PixelSaver/twoporthub/media/Pasted image 20260729214740.png

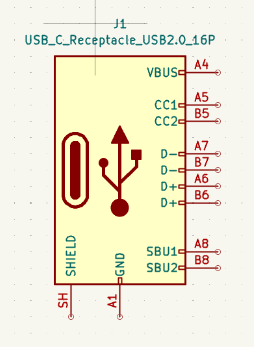
media/Pasted image 20260729214740.png
