PixelSaver/twoporthub/media/Pasted image 20260729220539.png

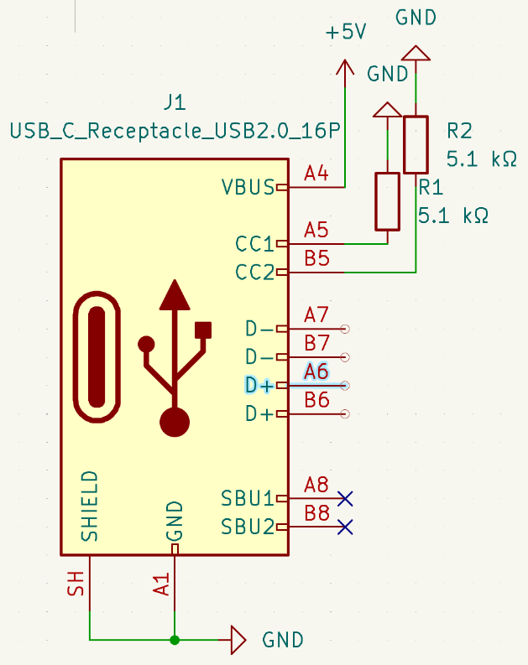
media/Pasted image 20260729220539.png
