PixelSaver/twoporthub/media/Pasted image 20260729221116.png

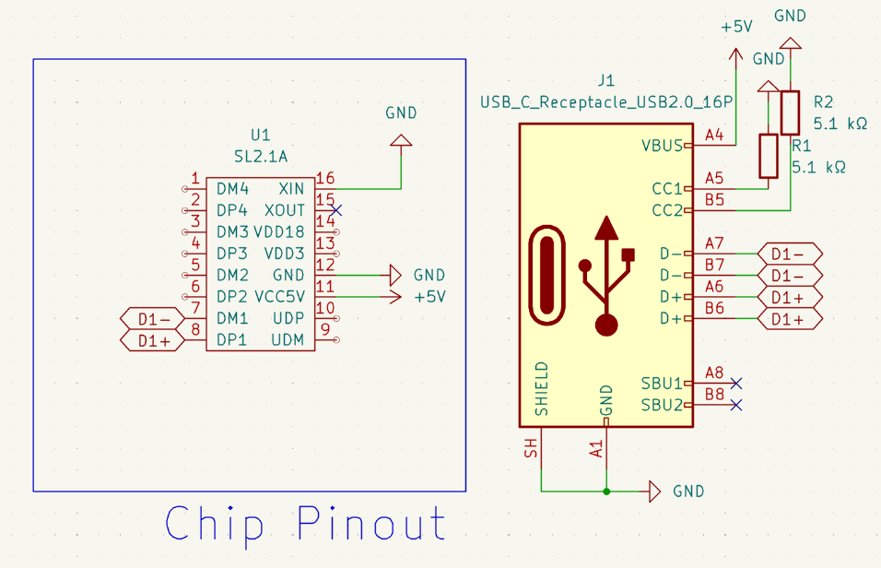
media/Pasted image 20260729221116.png
