PixelSaver/twoporthub/media/Pasted image 20260729222917.png

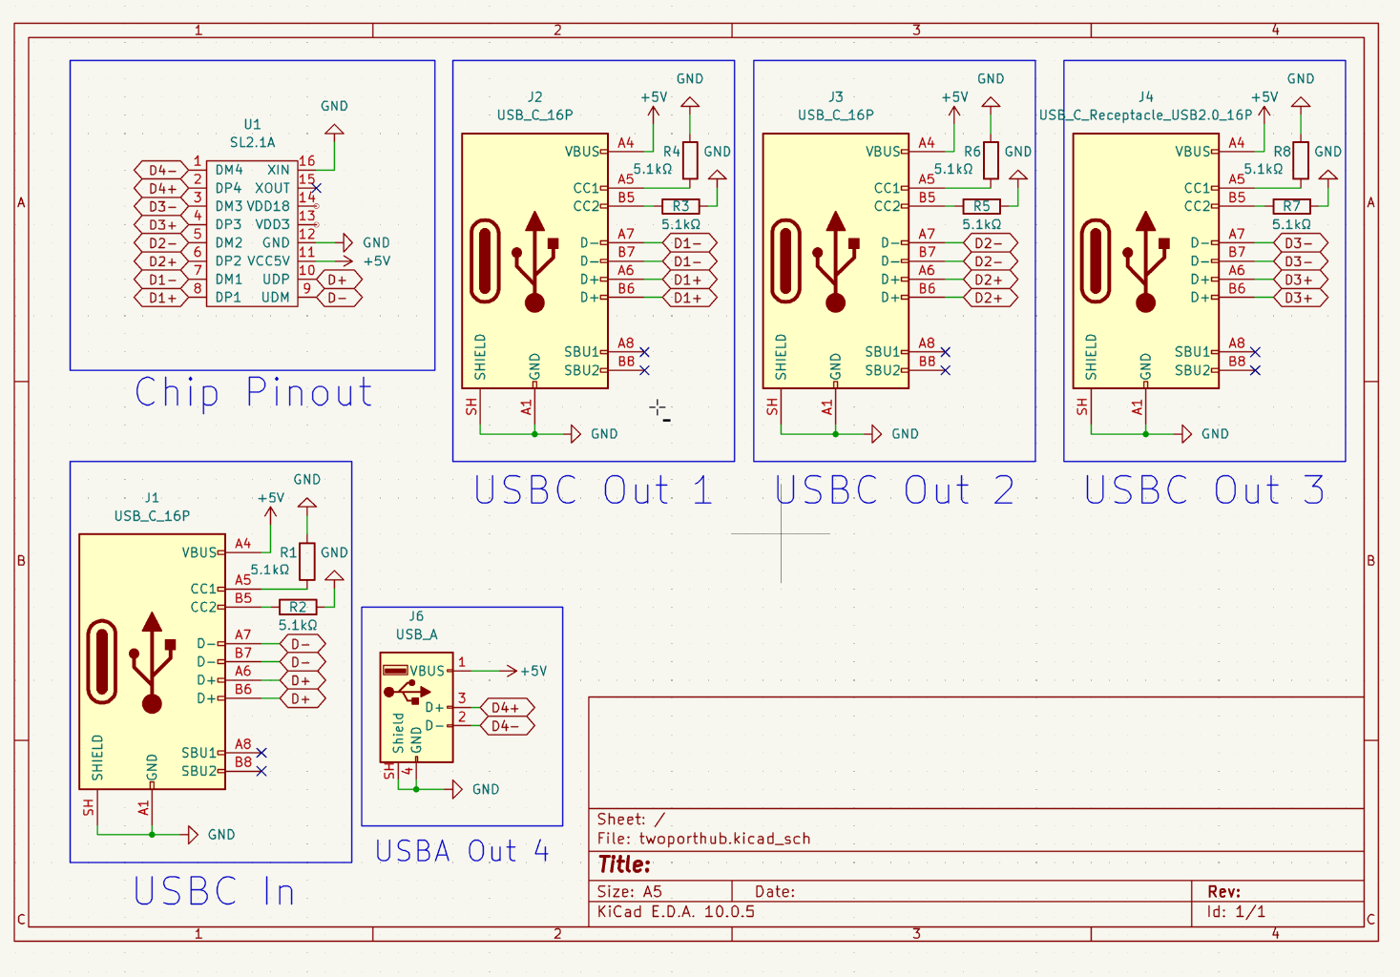
media/Pasted image 20260729222917.png
