PixelSaver/twoporthub/media/Pasted image 20260731172851.png

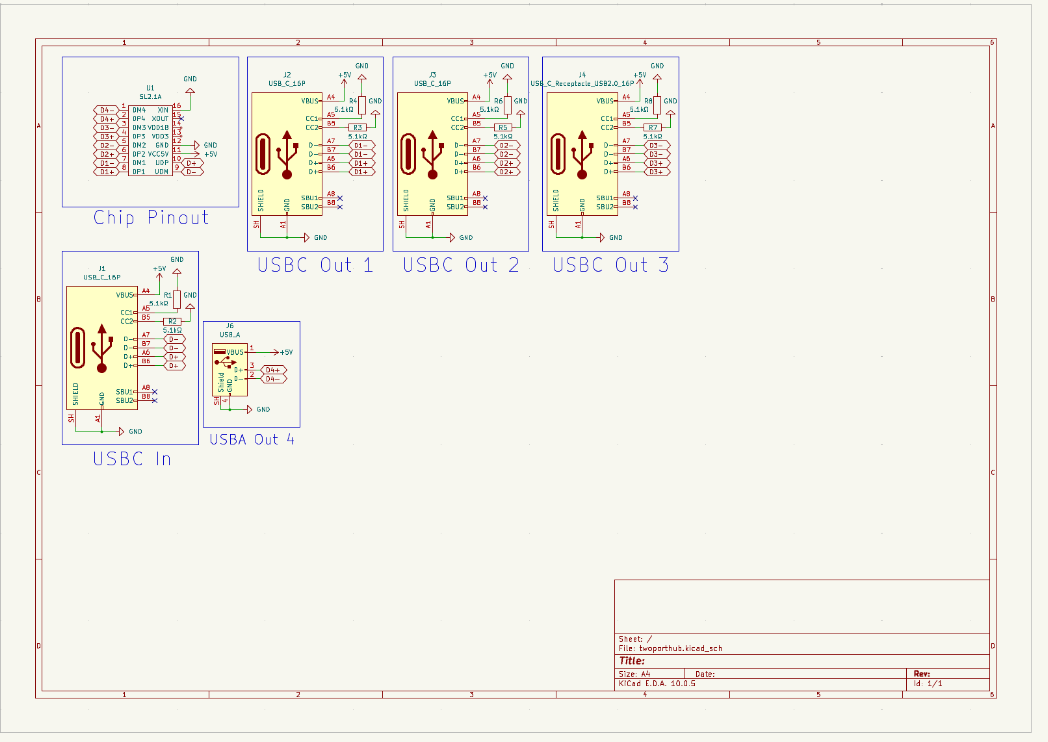
media/Pasted image 20260731172851.png
