PixelSaver/twoporthub/media/Pasted image 20260731180105.png

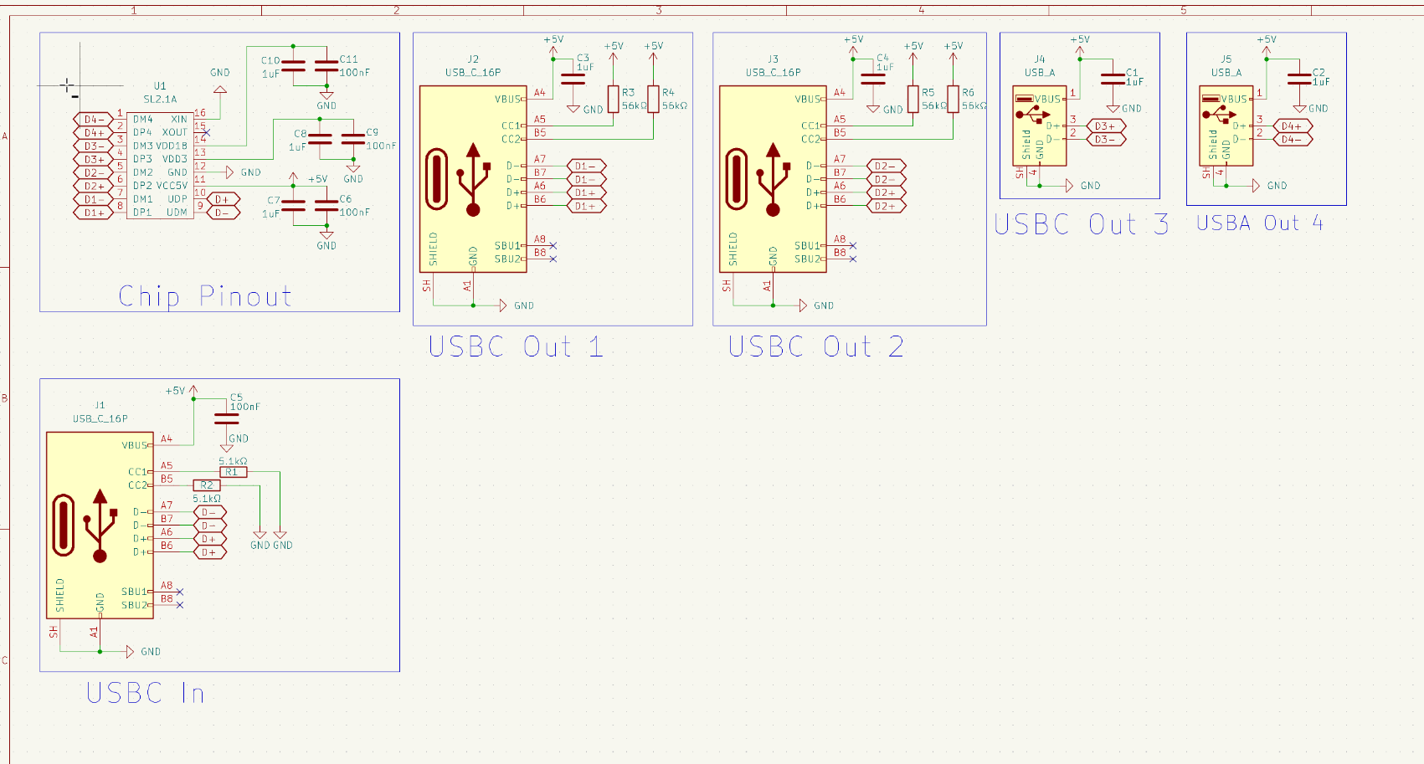
media/Pasted image 20260731180105.png
