PixelSaver/twoporthub/media/Pasted image 20260731182231.png

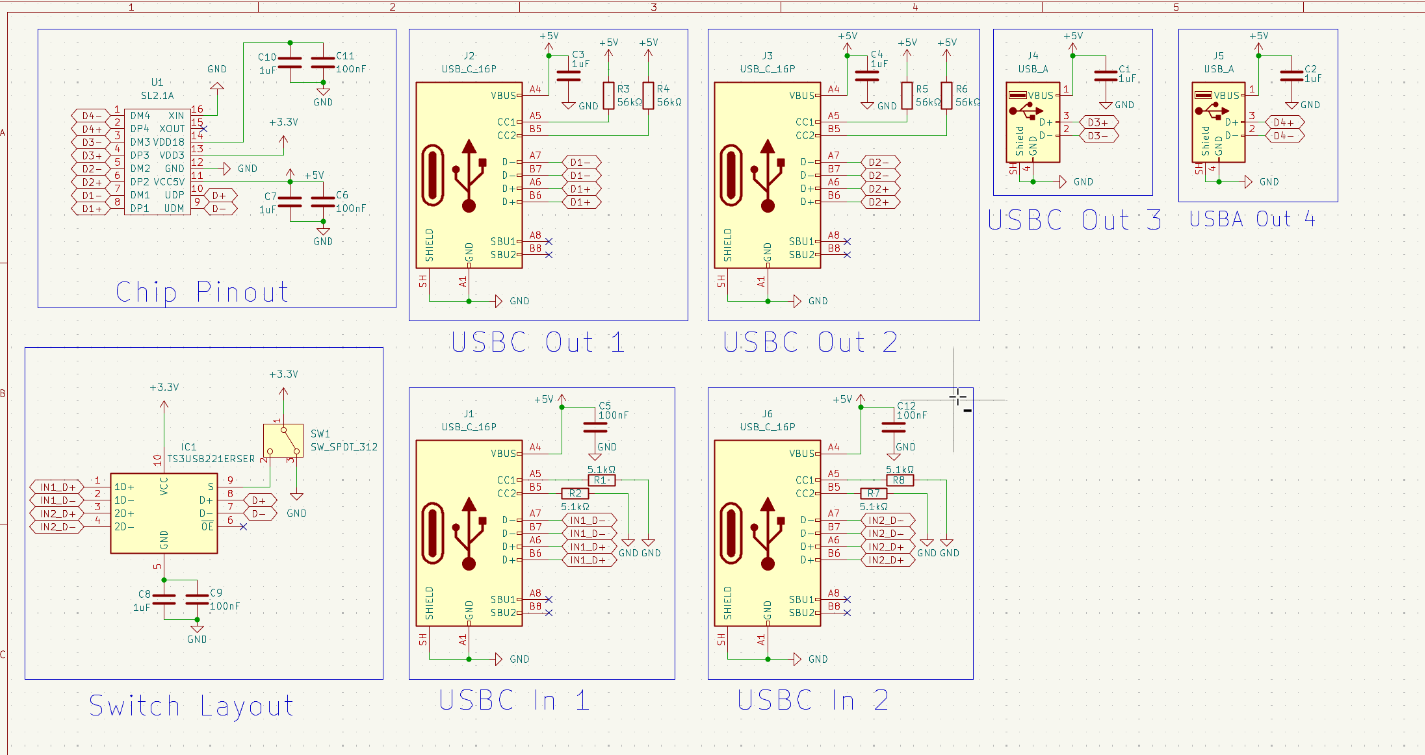
media/Pasted image 20260731182231.png
