PixelSaver/twoporthub/media/Pasted image 20260731183033.png

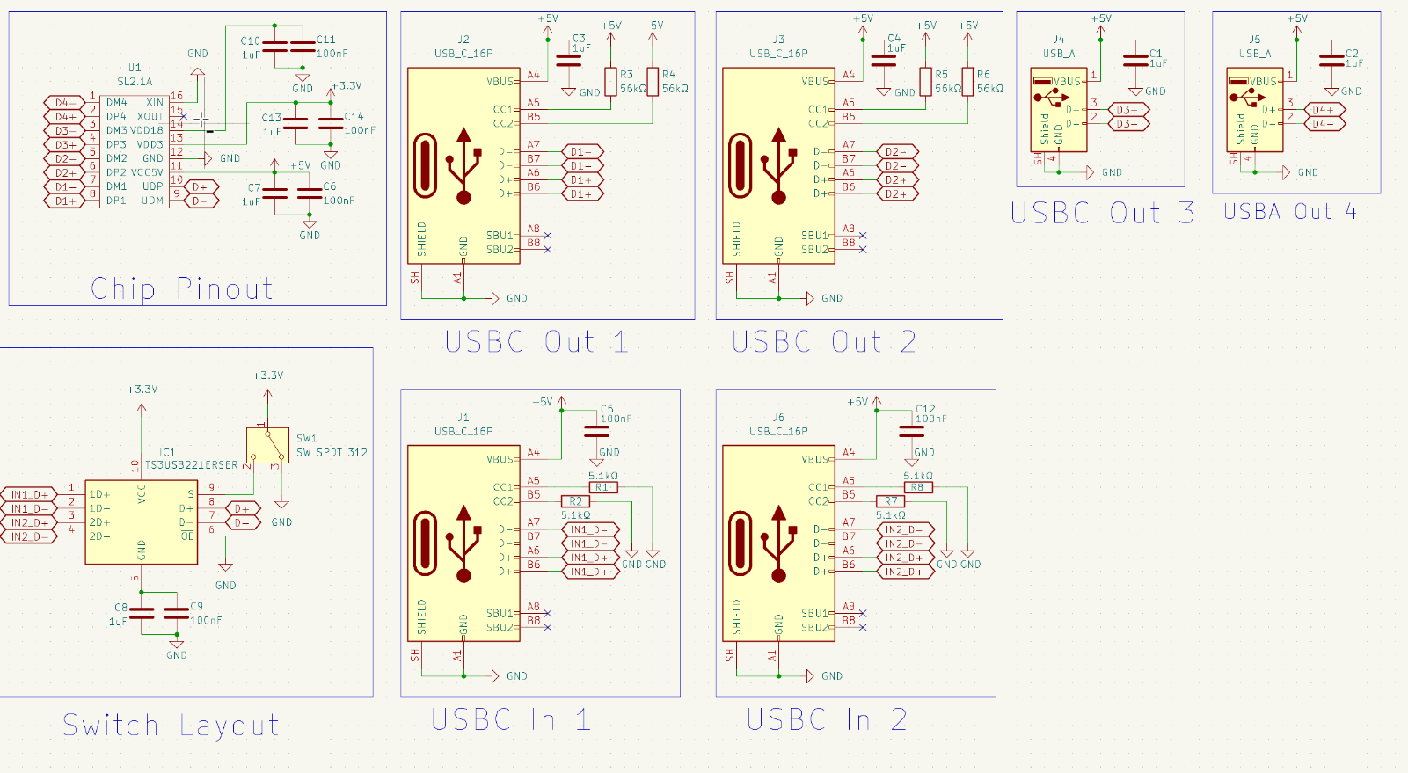
media/Pasted image 20260731183033.png
