PixelSaver/twoporthub/media/Pasted image 20260802001334.png

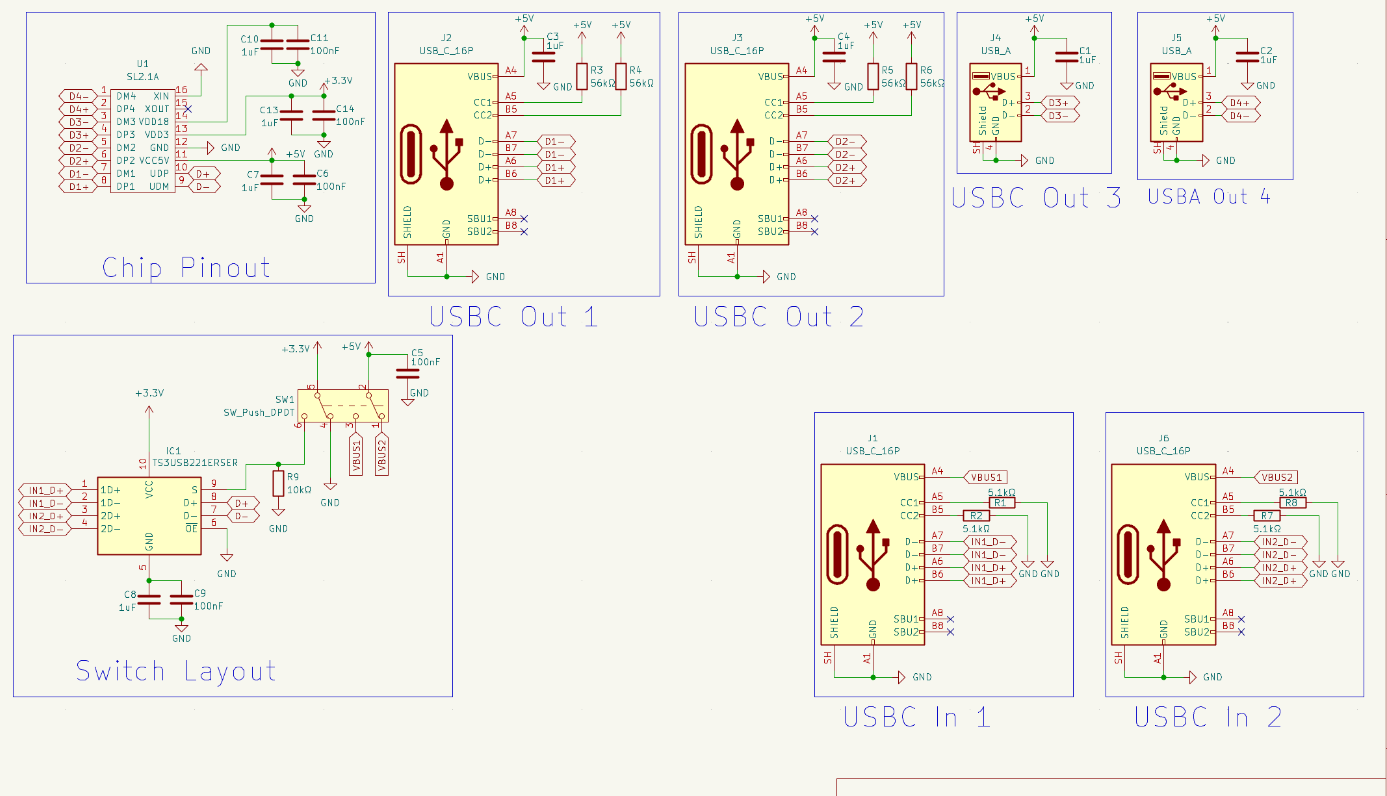
media/Pasted image 20260802001334.png
