PixelSaver/twoporthub/media/Pasted image 20260802005855.png

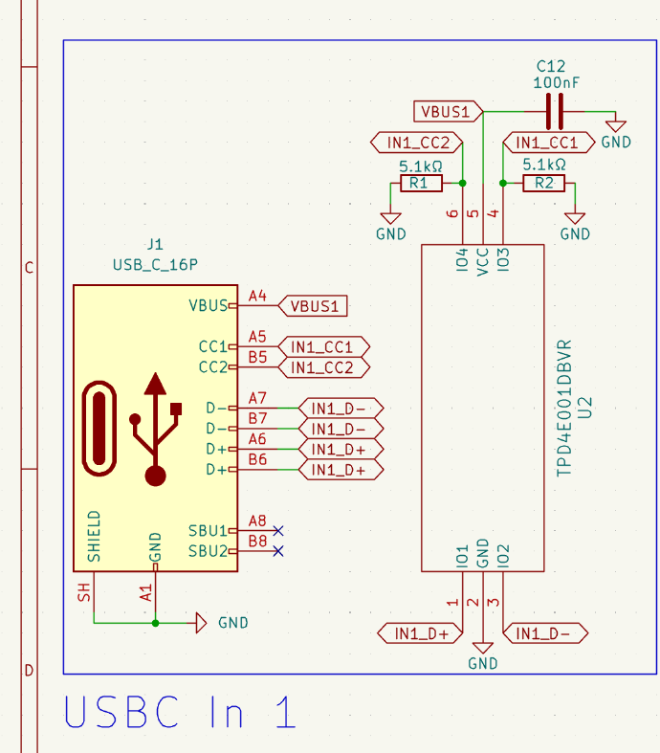
media/Pasted image 20260802005855.png
