PixelSaver/twoporthub/media/Pasted image 20260808122442.png

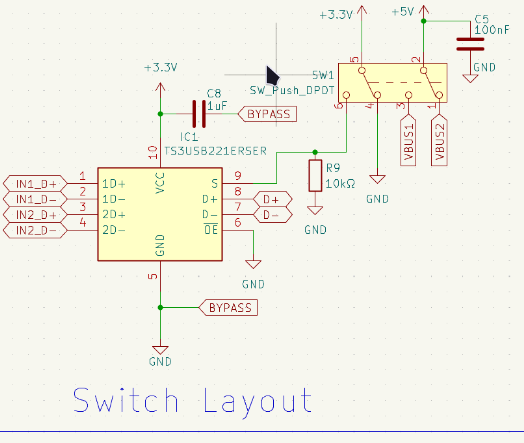
media/Pasted image 20260808122442.png
