PixelSaver/twoporthub/media/Pasted image 20260818155118.png

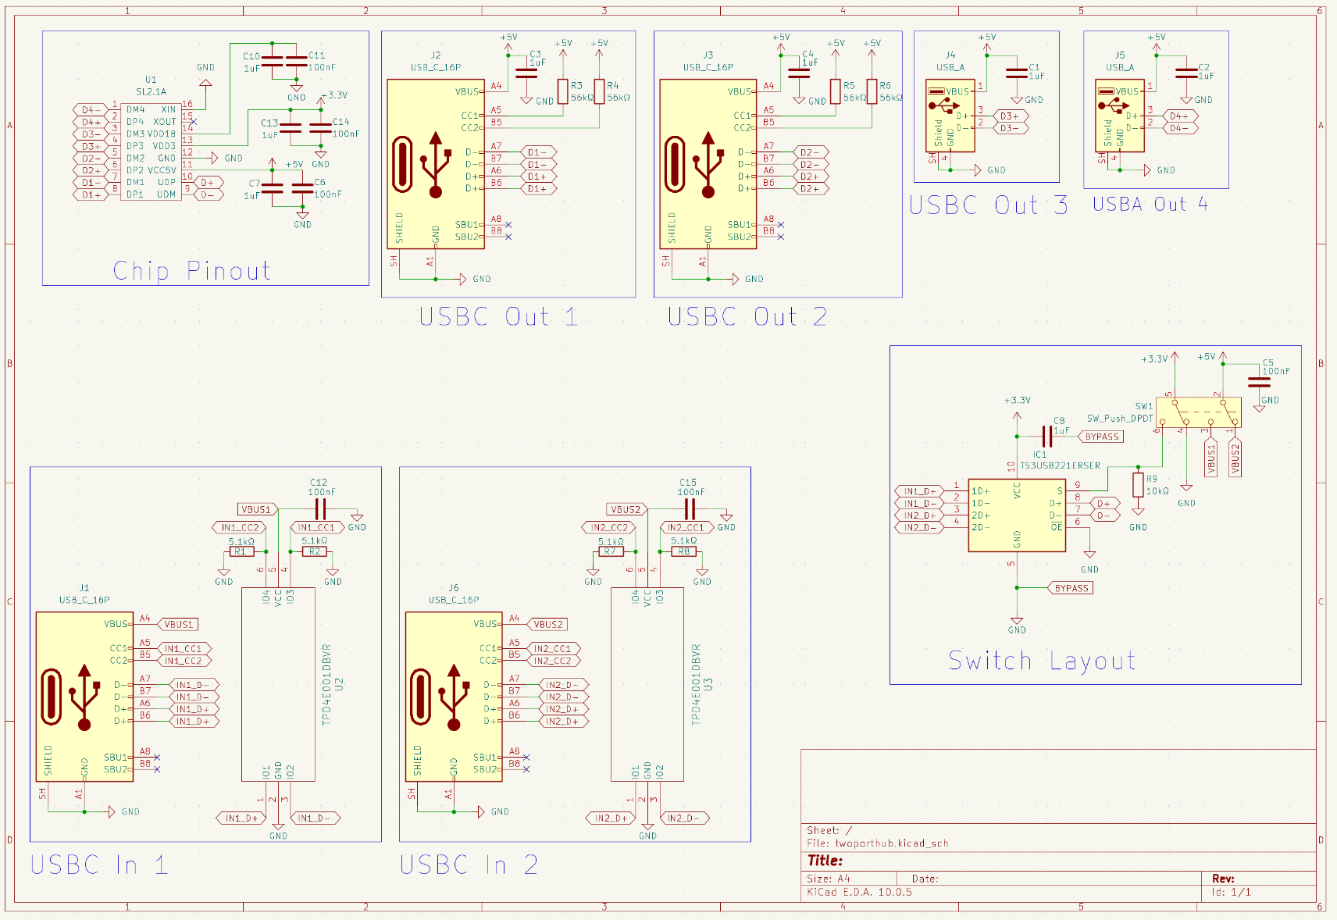
media/Pasted image 20260818155118.png
