PixelSaver/twoporthub/media/Pasted image 20260818162303.png

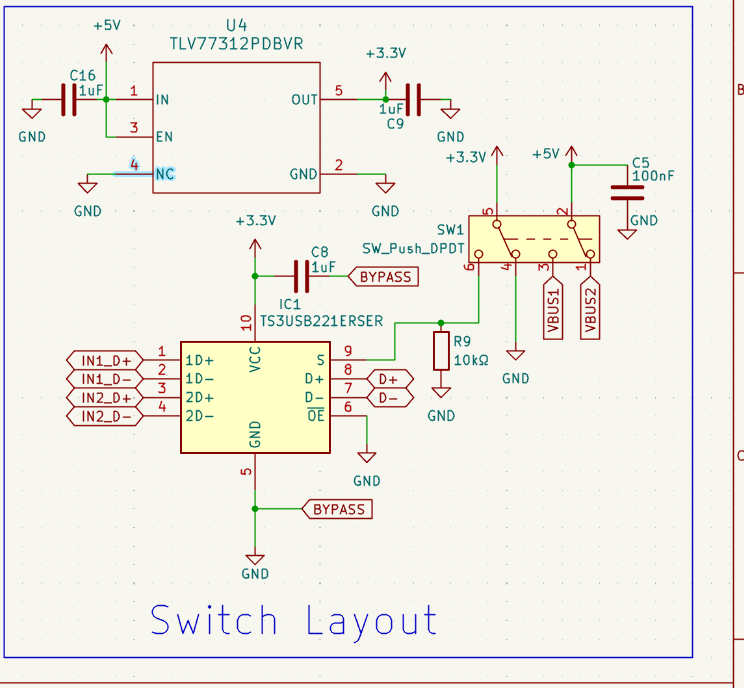
media/Pasted image 20260818162303.png
