PixelSaver/twoporthub/media/Pasted image 20260818162325.png

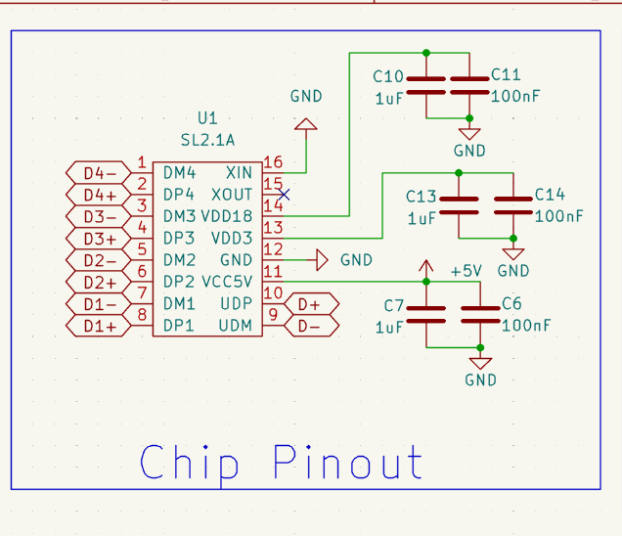
media/Pasted image 20260818162325.png
