PixelSaver/twoporthub/media/Pasted image 20260818170334.png

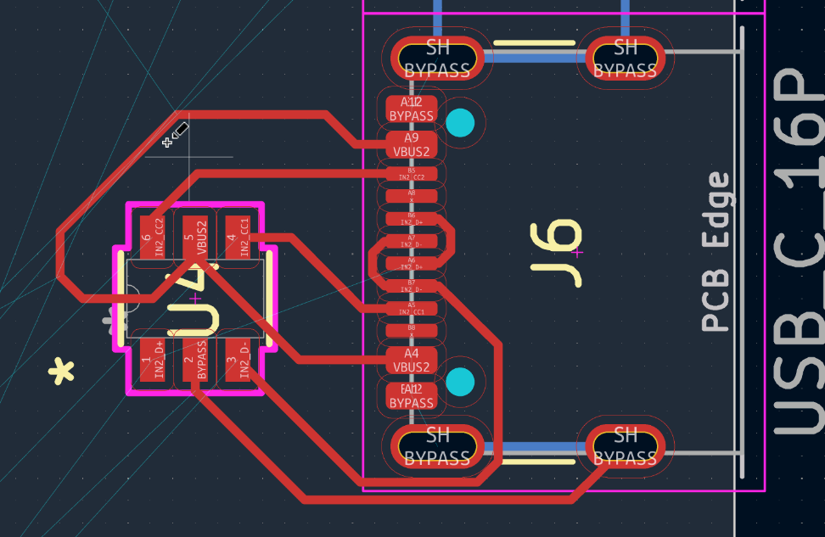
media/Pasted image 20260818170334.png
