PixelSaver/twoporthub/media/Pasted image 20260818170638.png

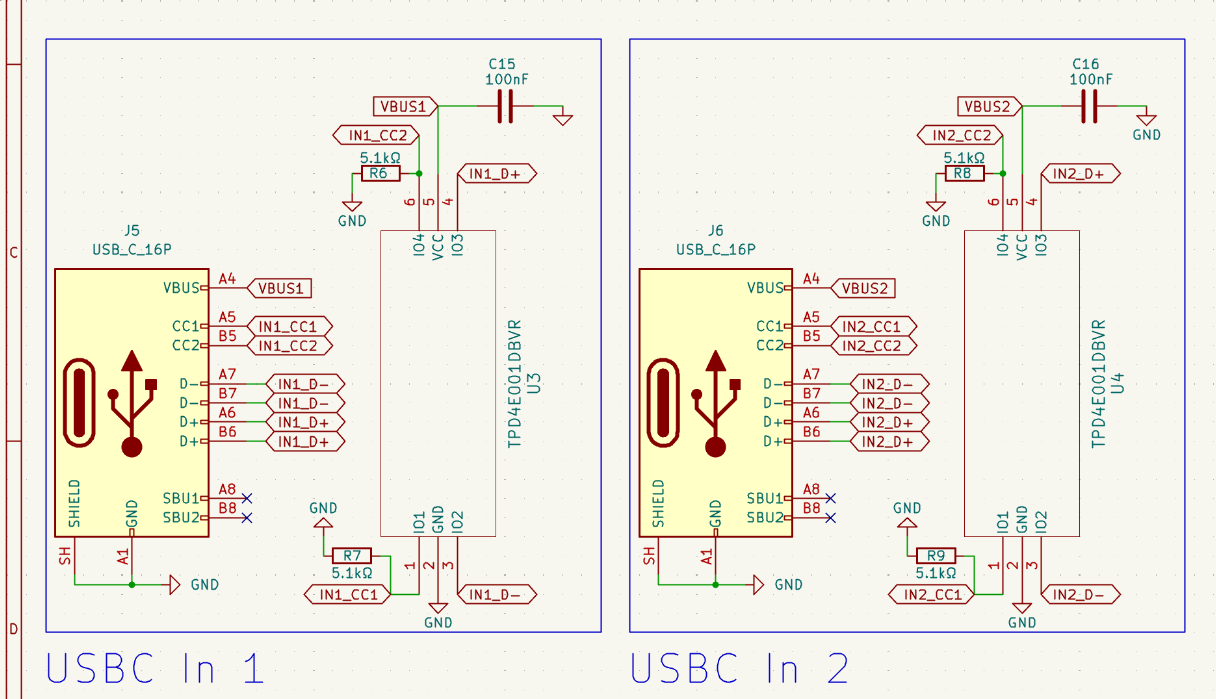
media/Pasted image 20260818170638.png
