PixelSaver/twoporthub/media/Pasted image 20260818170832.png

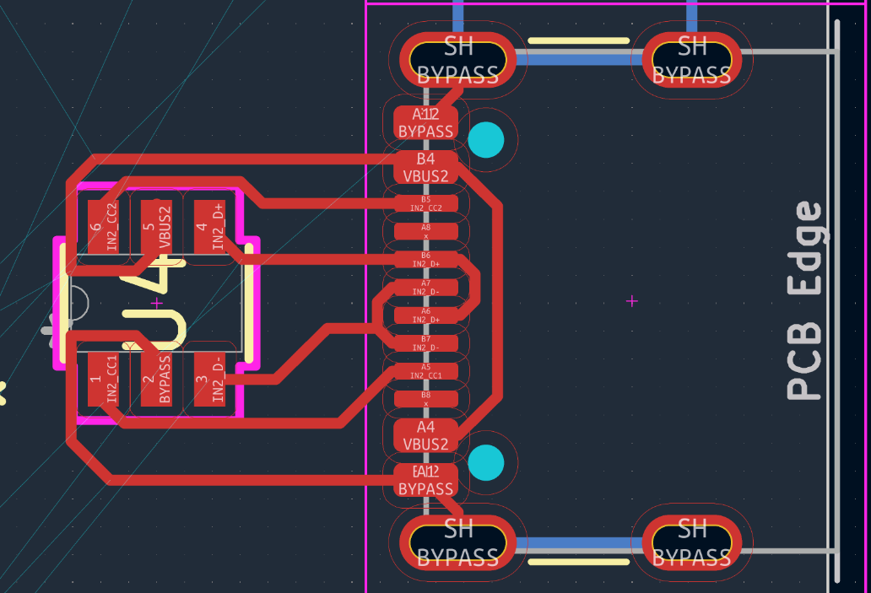
media/Pasted image 20260818170832.png
