PixelSaver/twoporthub/media/Pasted image 20260818171814.png

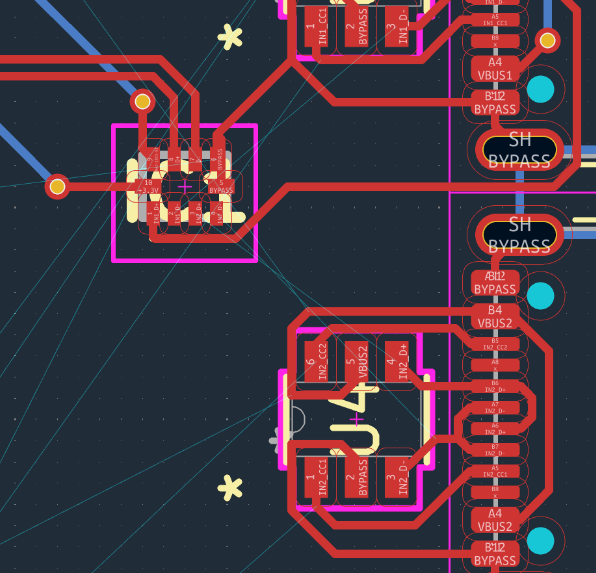
media/Pasted image 20260818171814.png
