PixelSaver/twoporthub/media/Pasted image 20260818174155.png

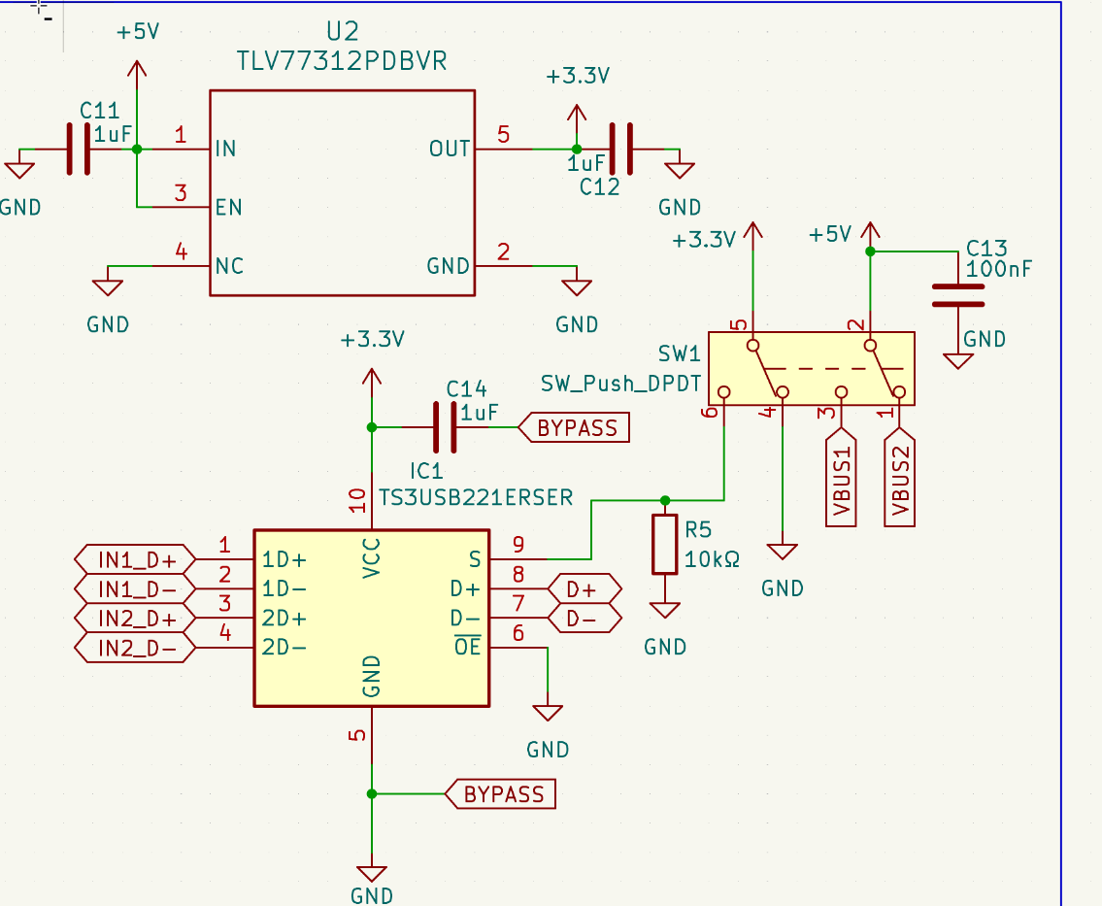
media/Pasted image 20260818174155.png
