PixelSaver/twoporthub/media/Pasted image 20260818182758.png

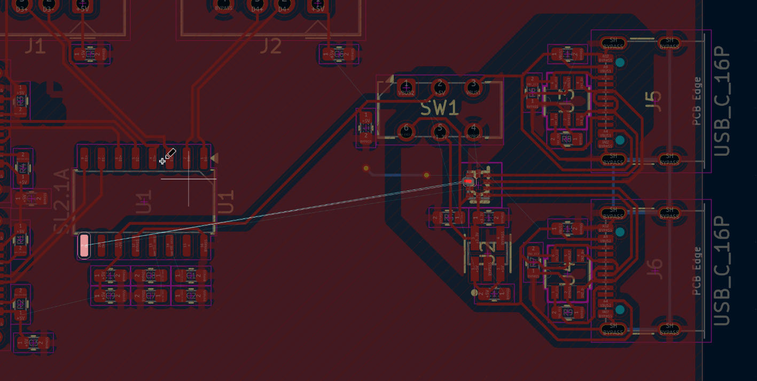
media/Pasted image 20260818182758.png
