PixelSaver/twoporthub/media/Pasted image 20260818183152.png

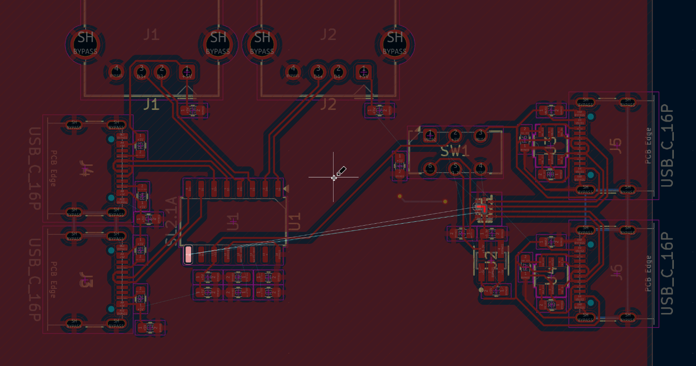
media/Pasted image 20260818183152.png
