PixelSaver/twoporthub/imports/3.3vregulator/DBV0005A.stp

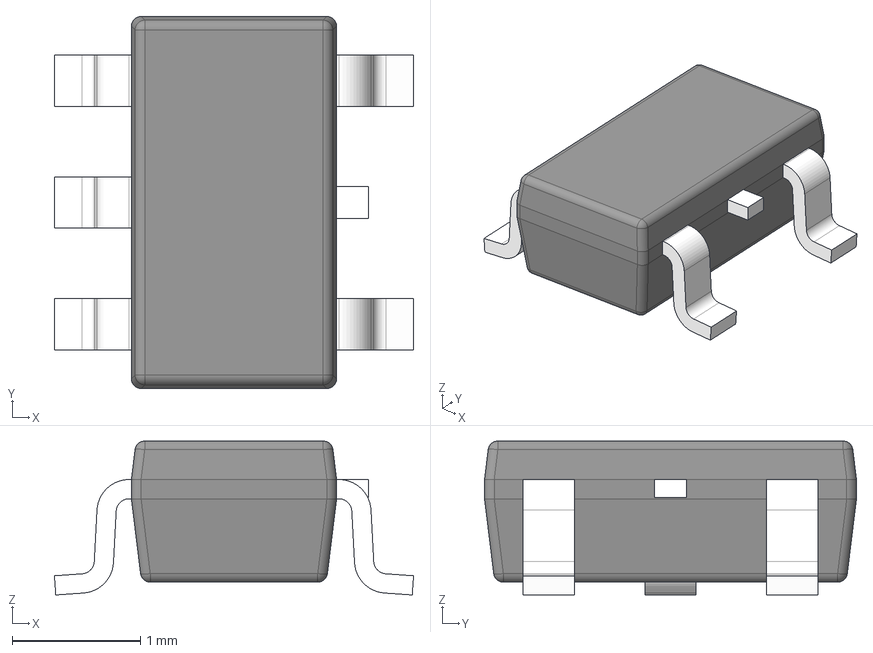
[picture p22: CAD file, 2026-08-18]
imports/3.3vregulator/DBV0005A.stp
2.80 x 2.90 x 1.20 mm
BODY-SOT
LEAD-SOT x 5
LEAD-DUMMY
