PixelSaver/twoporthub/imports/esd/DBV0006A.stp

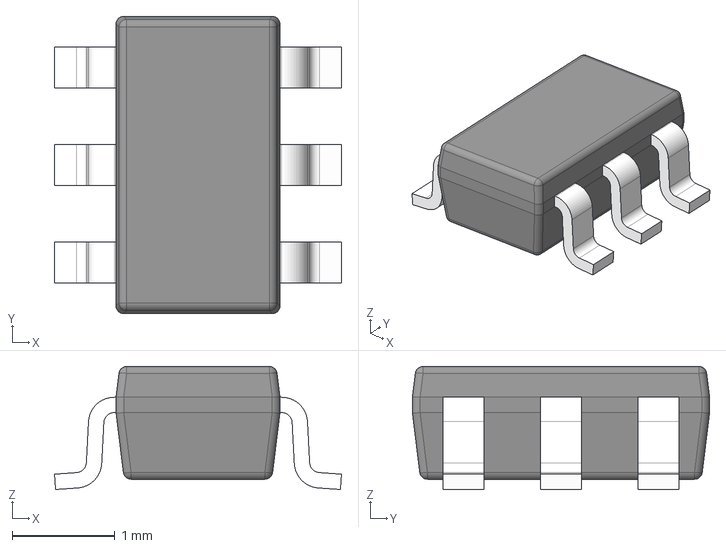
[picture p23: CAD file, 2026-08-02]
imports/esd/DBV0006A.stp
2.80 x 2.90 x 1.20 mm
BODY-SOT
LEAD-SOT x 6
