PixelSaver/twoporthub/imports/multiplexer/3D/TS3USB221ERSER.stp

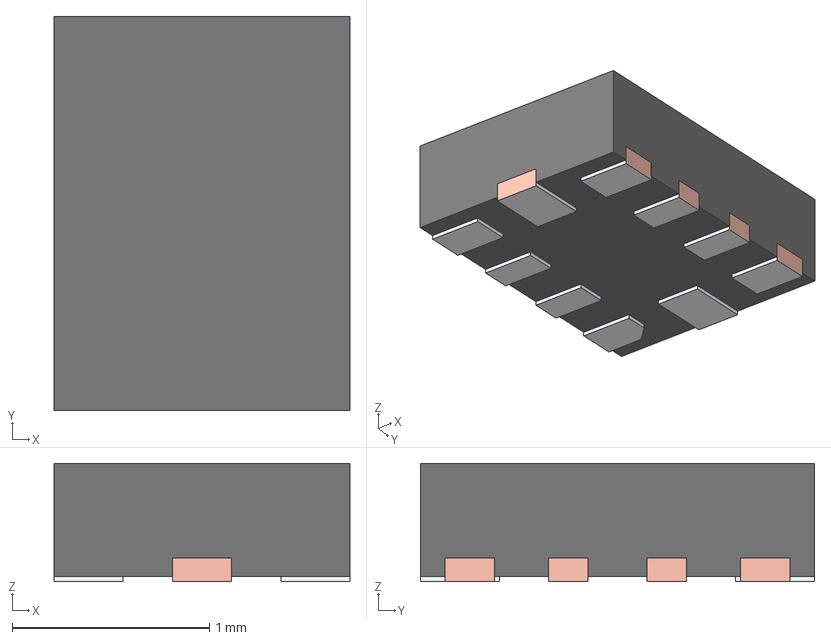
[picture p24: CAD file, 2026-08-01]
imports/multiplexer/3D/TS3USB221ERSER.stp
1.50 x 2.00 x 0.6 mm
FRAME-RSE0010A
BODY-QFN
PIN1-ID
