PixelSaver/twoporthub/imports/switch/mts102.step

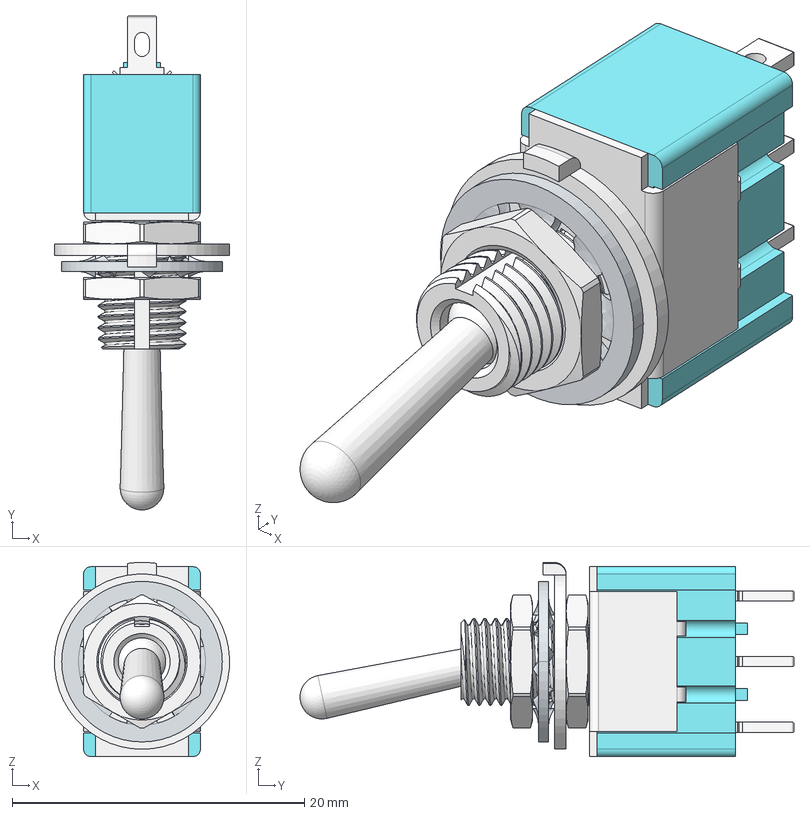
[picture p25: CAD file, 2026-08-01]
imports/switch/mts102.step
12.0 x 33.8 x 13.3 mm
Metal_part
Polyamide_body
Terminal x 3
Nut_h
Internal_Tooth_Lock_Washers
Keyed_washer
Nut_B
