PixelSaver/twoporthub/pcb/_restore_backup_2026-08-18T18-22-39-525/twoporthub.kicad_pcb

## KiCad design pcb/_restore_backup_2026-08-18T18-22-39-525/twoporthub.kicad_pcb (2026-08-19)

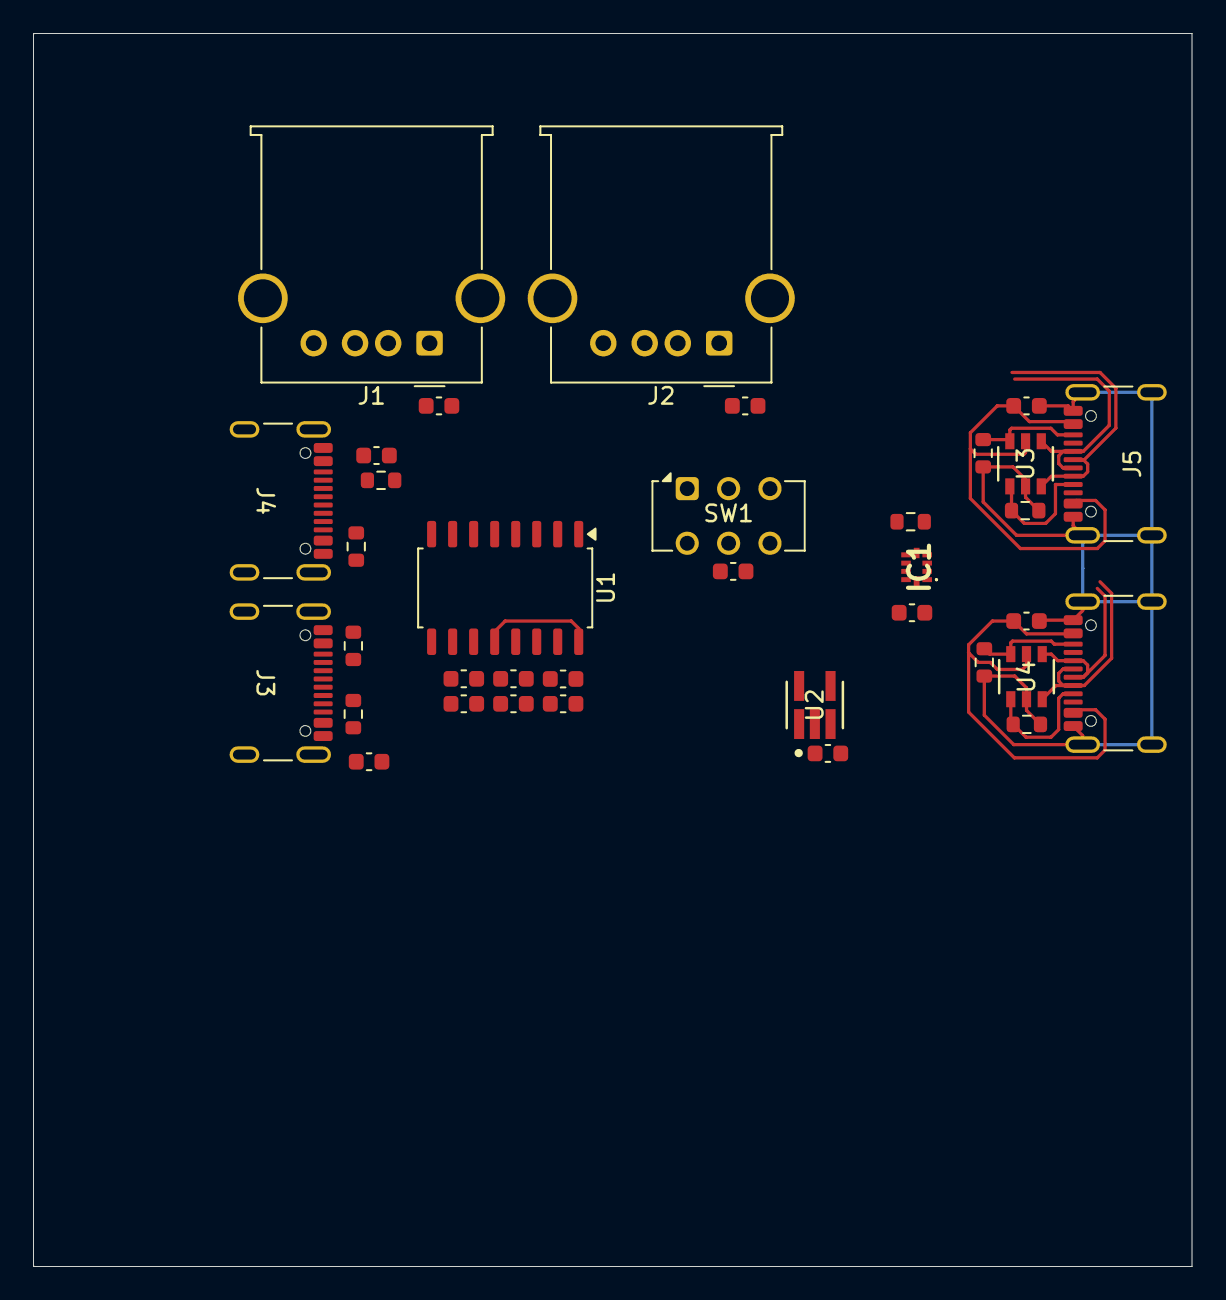
[picture p26: board twoporthub.kicad_pcb from above]

Board: 2 copper layers, 70.0 x 74.5 mm, 36 parts (0 on the bottom side), 30 nets.

Parts:
C1, C3, C4, C5, C6, C7, C9, C11, C12, C13: 1uF; C_0603_1608Metric
C2, C8, C10, C14, C15: 100nF; C_0603_1608Metric
IC1: TS3USB221ERSER
J1, J2: USB_A; USB_A_Molex_67643_Horizontal
J3, J4, J5, J6: USB_C_16P; USB_C_Receptacle_GCT_USB4105-xx-A_16P_TopMnt_Horizontal
R1, R2, R3, R4: 56kΩ; R_0603_1608Metric
R5: 10kΩ; R_0603_1608Metric
R6, R7, R8, R9: 5.1kΩ; R_0603_1608Metric
SW1: SW_Push_DPDT; SW_CK_JS202011CQN_DPDT_Straight
U1: SL2.1A; SOIC-16_4.55x10.3mm_P1.27mm
U2: TLV77312PDBVR; DBV0005A-IPC_A
U3, U4: TPD4E001DBVR; DBV6

Connections:
+3.3V: C12.2, C13.1, IC1.10 (VCC), SW1.5 (B), U2.5 (OUT)
+5V: C3.1, C4.1, C5.1, C6.1, C9.1, C10.1, C11.2, J1.1 (VBUS), J2.1 (VBUS), J3.A4 (VBUS), J3.A9 (VBUS), J3.B4 (VBUS), J3.B9 (VBUS), J4.A4 (VBUS), J4.A9 (VBUS), J4.B4 (VBUS), J4.B9 (VBUS), R1.1, R2.1, R3.1, R4.1, SW1.2 (B), U1.11 (VCC5V), U2.1 (IN), U2.3 (EN)
BYPASS: C1.2, C2.2, C3.2, C4.2, C5.2, C6.2, C7.2, C8.2, C9.2, C10.2, C11.1, C12.1, C13.2, C14.2, C15.2, IC1.5 (GND), IC1.6 (~OE), J1.4 (GND), J1.SH (Shield), J2.4 (GND), J2.SH (Shield), J3.A1 (GND), J3.A12 (GND), J3.B1 (GND), J3.B12 (GND), J3.SH (SHIELD), J4.A1 (GND), J4.A12 (GND), J4.B1 (GND), J4.B12 (GND), J4.SH (SHIELD), J5.A1 (GND), J5.A12 (GND), J5.B1 (GND), J5.B12 (GND), J5.SH (SHIELD), J6.A1 (GND), J6.A12 (GND), J6.B1 (GND), J6.B12 (GND), J6.SH (SHIELD), R5.2, R6.1, R7.1, R8.1, R9.1, SW1.4 (A), U1.12 (GND), U1.16 (XIN), U2.2 (GND), U2.4 (NC), U3.2 (GND), U4.2 (GND)
D1+: J3.A6 (D+), J3.B6 (D+), U1.8 (DP1)
D1-: J3.A7 (D-), J3.B7 (D-), U1.7 (DM1)
D2+: J4.A6 (D+), J4.B6 (D+), U1.6 (DP2)
D2-: J4.A7 (D-), J4.B7 (D-), U1.5 (DM2)
D3+: J1.3 (D+), U1.4 (DP3)
D3-: J1.2 (D-), U1.3 (DM3)
D4+: J2.3 (D+), U1.2 (DP4)
D4-: J2.2 (D-), U1.1 (DM4)
D+: IC1.8 (D+), U1.10 (UDP)
D-: IC1.7 (D-), U1.9 (UDM)
IN1_CC1: J5.A5 (CC1), R8.2, U3.1 (IO1)
IN1_CC2: J5.B5 (CC2), R6.2, U3.6 (IO4)
IN1_D+: IC1.1 (1D+), J5.A6 (D+), J5.B6 (D+), U3.4 (IO3)
IN1_D-: IC1.2 (1D-), J5.A7 (D-), J5.B7 (D-), U3.3 (IO2)
IN2_CC1: J6.A5 (CC1), R9.2, U4.1 (IO1)
IN2_CC2: J6.B5 (CC2), R7.2, U4.6 (IO4)
IN2_D+: IC1.3 (2D+), J6.A6 (D+), J6.B6 (D+), U4.4 (IO3)
IN2_D-: IC1.4 (2D-), J6.A7 (D-), J6.B7 (D-), U4.3 (IO2)
unnamed: IC1.9 (S), R5.1, SW1.6 (C)
unnamed: J3.A5 (CC1), R1.2
unnamed: J3.B5 (CC2), R2.2
unnamed: J4.A5 (CC1), R3.2
unnamed: J4.B5 (CC2), R4.2
unnamed: C7.1, C8.1, U1.13 (VDD3)
unnamed: C1.1, C2.1, U1.14 (VDD18)
VBUS1: C14.1, J5.A4 (VBUS), J5.A9 (VBUS), J5.B4 (VBUS), J5.B9 (VBUS), SW1.3 (C), U3.5 (VCC)
VBUS2: C15.1, J6.A4 (VBUS), J6.A9 (VBUS), J6.B4 (VBUS), J6.B9 (VBUS), SW1.1 (A), U4.5 (VCC)
