PixelSaver/twoporthub/simple_sl2.1a_usb_hub-main/simple_sl2.1a_usb_hub.kicad_pcb

## KiCad design simple_sl2.1a_usb_hub-main/simple_sl2.1a_usb_hub.kicad_pcb (2026-07-30)

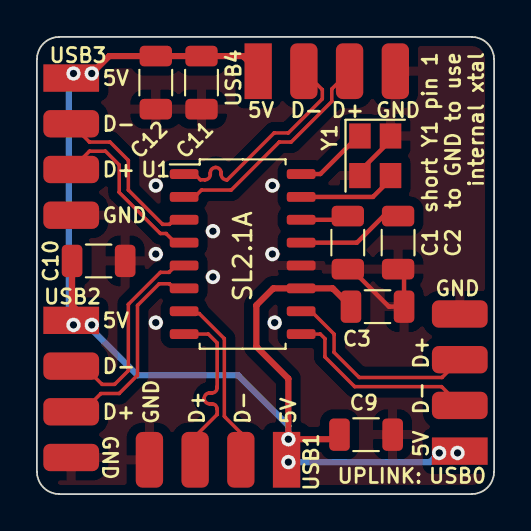
[picture p27: board simple_sl2.1a_usb_hub.kicad_pcb from above]

Board: 2 copper layers, 25.4 x 25.4 mm, 14 parts (0 on the bottom side), 16 nets.

Parts:
C1, C2, C3: 10uF; C_1206_3216Metric
C9, C10, C11, C12: 100uF/16V; C_1206_3216Metric
U1: SL2.1A; SOIC-16_4.55x10.3mm_P1.27mm
USB0, USB1, USB2, USB3, USB4: Conn_01x04_Male; 2.54mm 1x4 header edge - no silks
Y1: Crystal_GND24; Crystal_SMD_3225-4Pin_3.2x2.5mm

Connections:
D1+: U1.8 (DP1), USB1.3
D1-: U1.7 (DM1), USB1.2
D2+: U1.6 (DP2), USB2.3
D2-: U1.5 (DM2), USB2.2
D3+: U1.4 (DP3), USB3.3
D3-: U1.3 (DM3), USB3.2
D4+: U1.2 (DP4), USB4.3
D4-: U1.1 (DM4), USB4.2
DU+: U1.10 (UDP), USB0.3
DU-: U1.9 (UDM), USB0.2
Earth: C1.2, C2.2, C3.2, C9.2, C10.2, C11.2, C12.2, U1.12 (GND), USB0.4, USB1.4, USB2.4, USB3.4, USB4.4, Y1.2, Y1.4
unnamed: C1.1, U1.14 (VDD18)
unnamed: C2.1, U1.13 (VDD3)
unnamed: U1.15 (XOUT), Y1.3
unnamed: U1.16 (XIN), Y1.1
VBUS: C3.1, C9.1, C10.1, C11.1, C12.1, U1.11 (VCC5V), USB0.1, USB1.1, USB2.1, USB3.1, USB4.1
