PixelSaver/twoporthub/(commit log)

2026-07-30 Added obsidian vault, and schematiced all of it
    [simple_sl2.1a_usb_hub.kicad_pcb, simple_sl2.1a_usb_hub.kicad_sch, twoporthub.kicad_pcb, twoporthub.kicad_sch]
2026-08-01 Imported a lot of models, and wrote up schematic for two upstream nodes and a switch
    [TS3USB221ERSER.stp, mts102.step, twoporthub.kicad_pcb, twoporthub.kicad_sch]
2026-08-02 Added esd protection to one poirt so far
    [DBV0006A.stp, twoporthub.kicad_sch]
2026-08-18 Added 3.3v regulator
    [DBV0005A.stp, twoporthub.kicad_sch]
2026-08-19 Worked until I realized some traces might be impossible
    [twoporthub.kicad_pcb, twoporthub.kicad_sch]
